ZelTroN-2k3/WelderPWM_News_Screen/photo/128x64 SSD1309, pilote IIC I2C.jpg

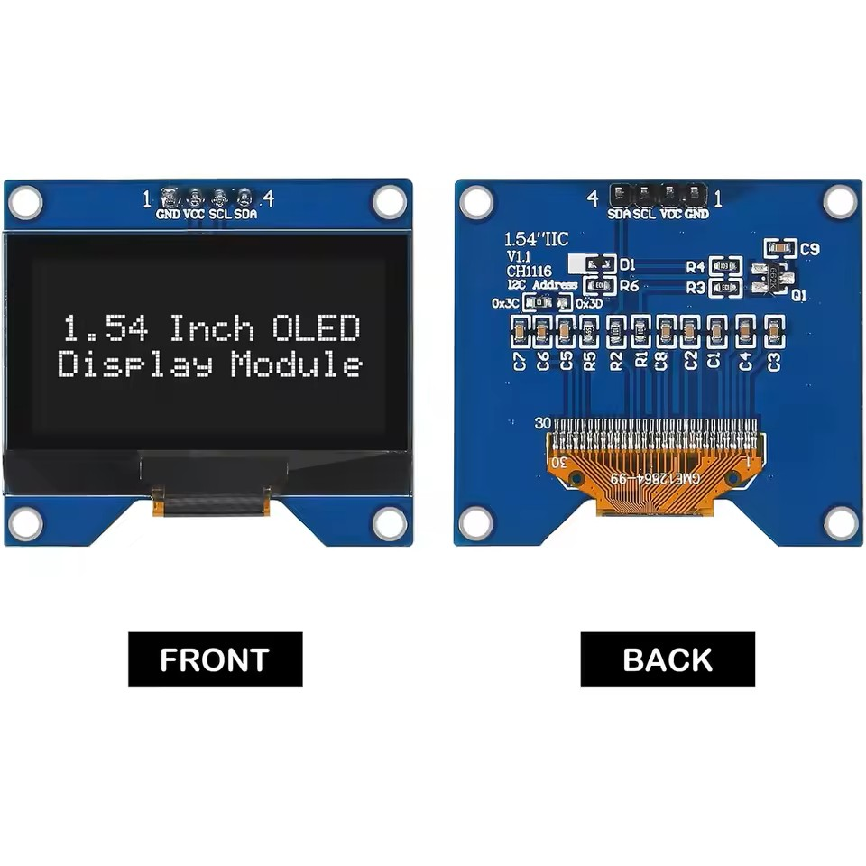
photo/128x64 SSD1309, pilote IIC I2C.jpg
