ZelTroN-2k3/WelderPWM_News_Screen/photo/5224271530660322055_120.jpg

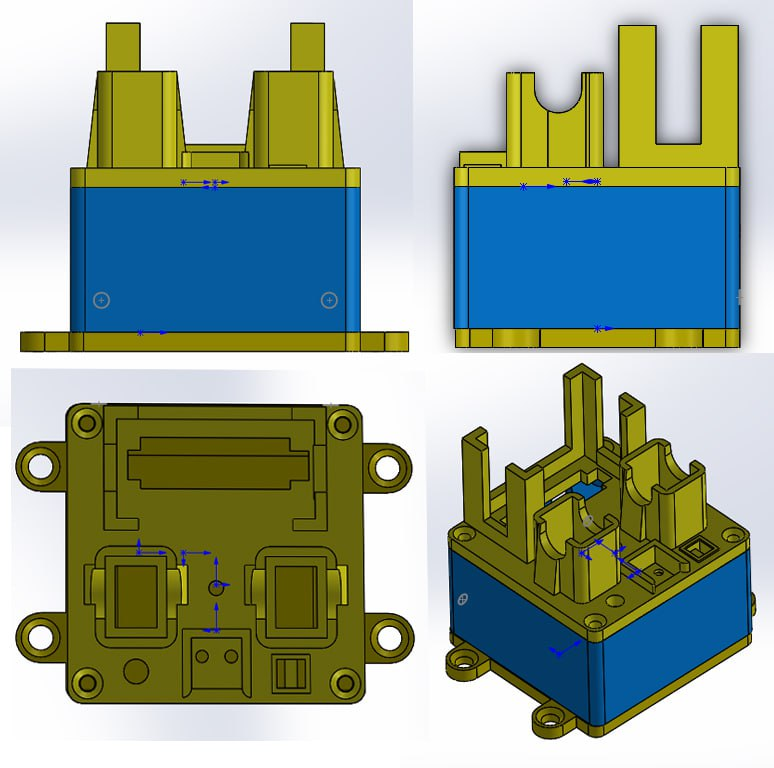
photo/5224271530660322055_120.jpg
