ZelTroN-2k3/WelderPWM_News_Screen/photo/5280480394728303123_121.jpg

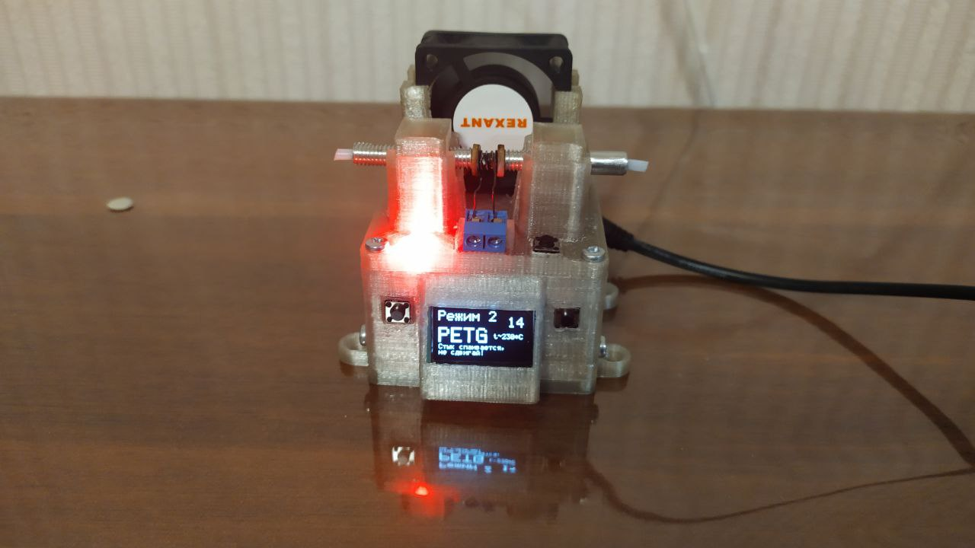
photo/5280480394728303123_121.jpg
