ZelTroN-2k3/WelderPWM_News_Screen/photo/5298588492248063706_121.jpg

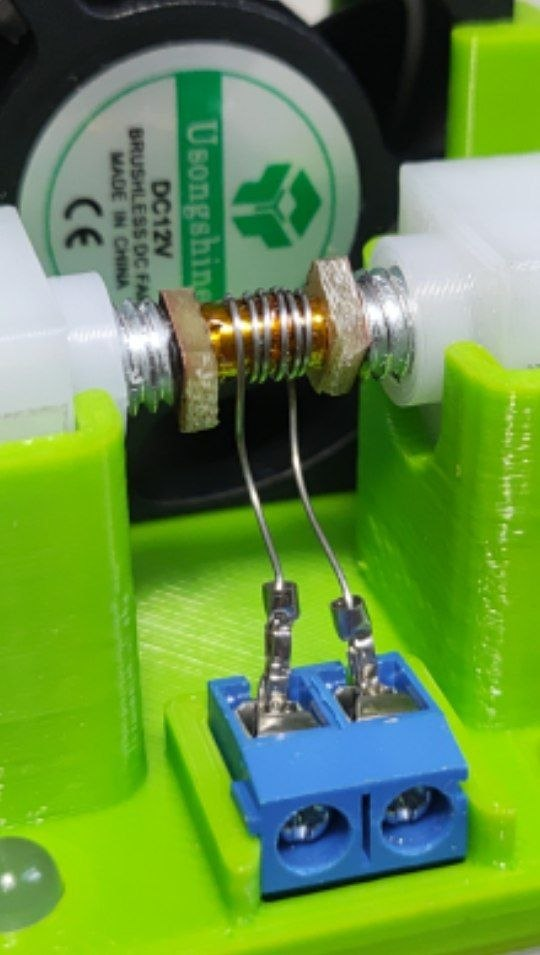
photo/5298588492248063706_121.jpg
