ZelTroN-2k3/WelderPWM_News_Screen/photo/5341638530003835500_119.jpg

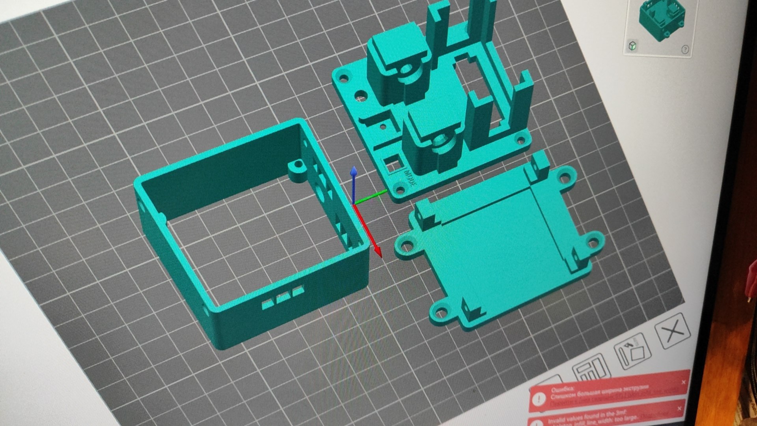
photo/5341638530003835500_119.jpg
