ZelTroN-2k3/WelderPWM_News_Screen/photo/5399879480538502821_120.jpg

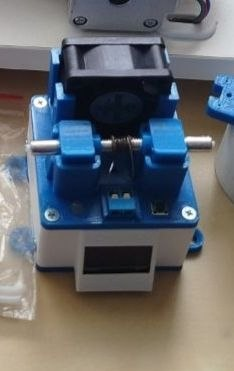
photo/5399879480538502821_120.jpg
