ZelTroN-2k3/WelderPWM_News_Screen/photo/plan-news.jpg

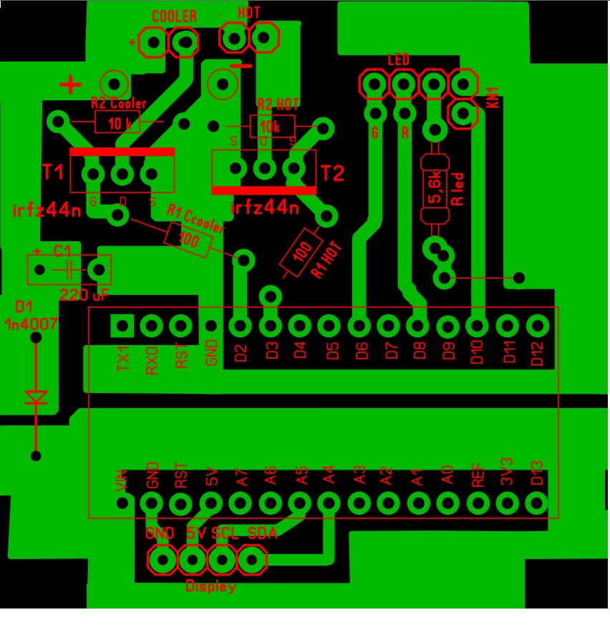
photo/plan-news.jpg
