ZelTroN-2k3/WelderPWM_News_Screen/photo/plan.png

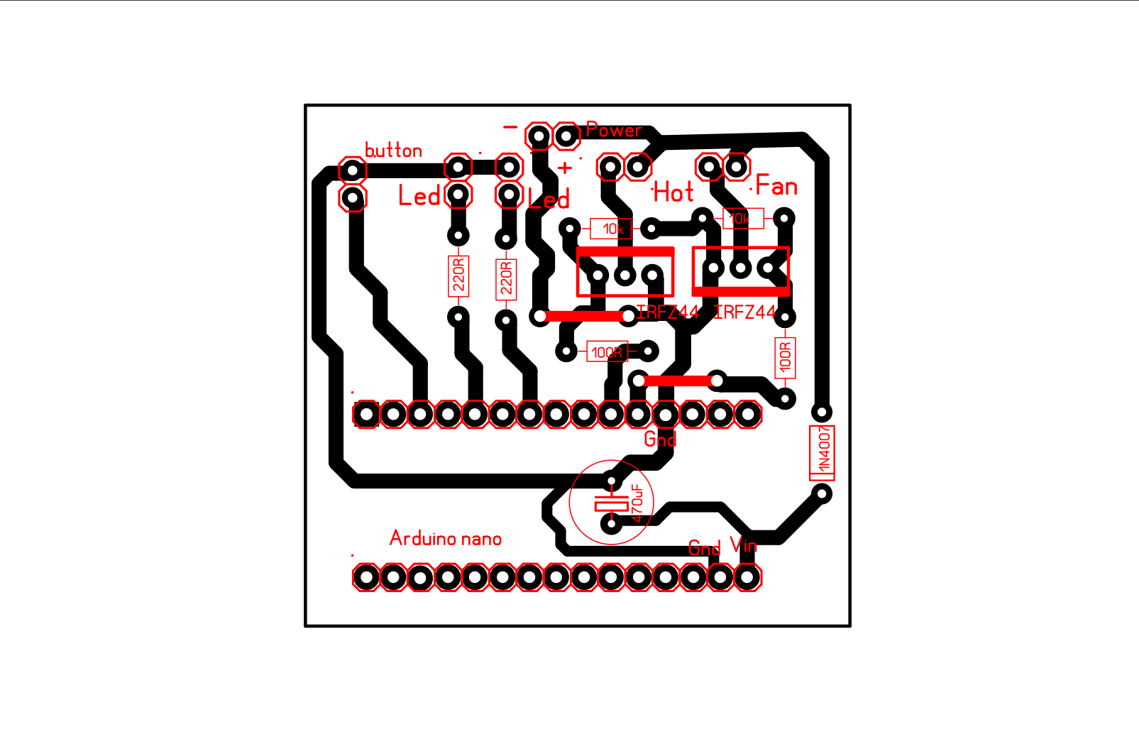
photo/plan.png
