ZelTroN-2k3/WelderPWM_News_Screen/News-Models STL/OLED-Display-Full.3mf

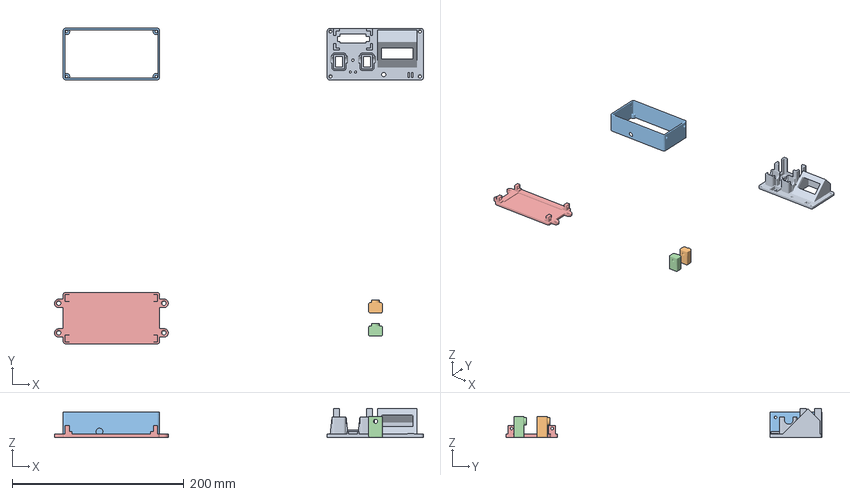
[picture p14: CAD file, 2026-08-10]
News-Models STL/OLED-Display-Full.3mf
429.2 x 367.4 x 34.0 mm
OLED-Display-Top.stl
OLED-Solder Cube.stl x 2
OLED-Display-Box.stl
OLED-Display-Side.stl
