ZelTroN-2k3/WelderPWM_News_Screen/News-Models STL/OLED-Display-Side.stl

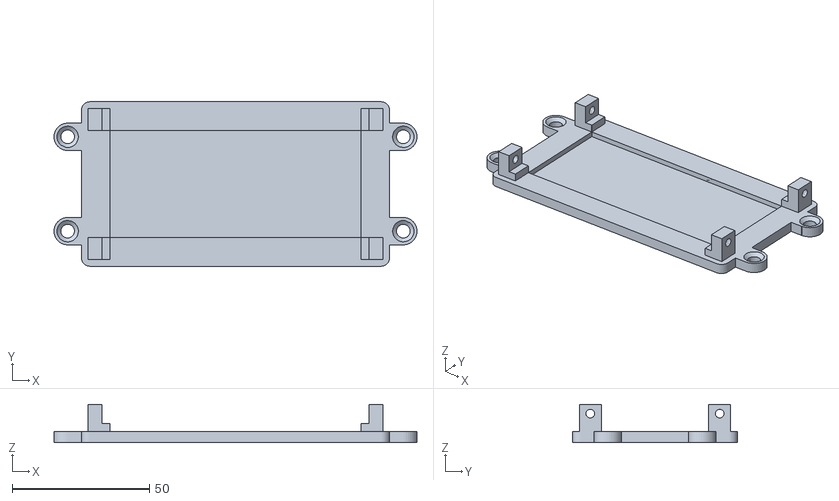
[picture p15: CAD file, 2026-08-10]
News-Models STL/OLED-Display-Side.stl
132.4 x 60.0 x 14.0
