ZelTroN-2k3/WelderPWM_News_Screen/News-Models STL/OLED-Display-Box.stl

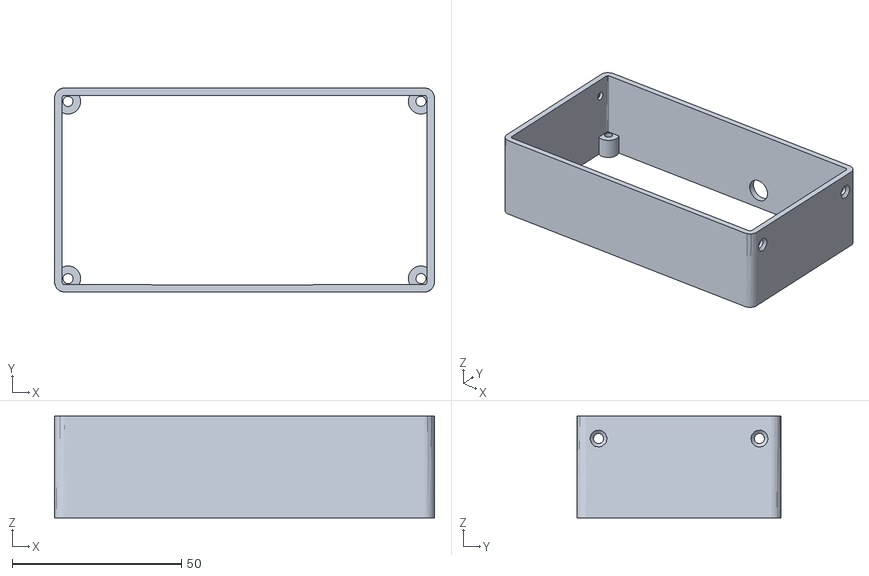
[picture p16: CAD file, 2026-08-10]
News-Models STL/OLED-Display-Box.stl
112.2 x 60.3 x 30.0
