ZelTroN-2k3/WelderPWM_News_Screen/News-Models STL/OLED-Display-Top.stl

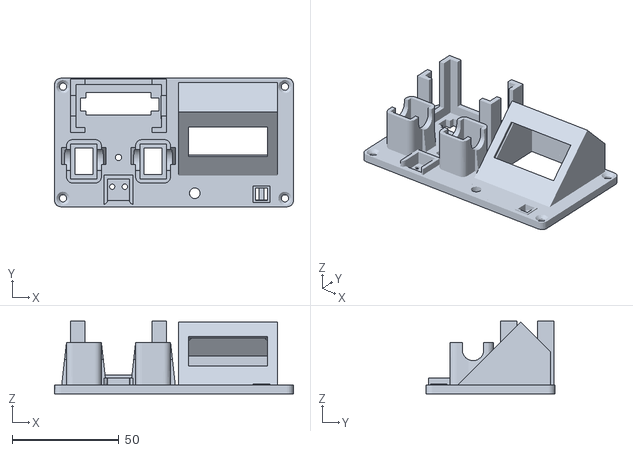
[picture p17: CAD file, 2026-08-10]
News-Models STL/OLED-Display-Top.stl
112.0 x 60.3 x 34.0
