ZelTroN-2k3/WelderPWM_News_Screen/News-Models STL/OLED-Solder Cube.stl

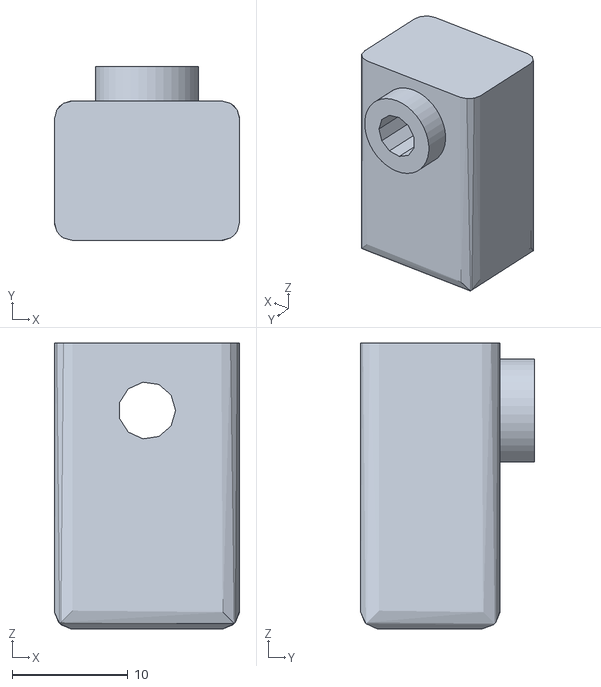
[picture p18: CAD file, 2026-08-10]
News-Models STL/OLED-Solder Cube.stl
16.0 x 15.0 x 24.8
