ZelTroN-2k3/WelderPWM_News_Screen/WelderPWM_new_3_Screen_EN/Globals.h

#ifndef GLOBALS_H
#define GLOBALS_H

#include "Config.h"
#include <U8glib.h>
#include <EncButton.h>
#include <EEPROM.h>
#include <Wire.h>

// Shared hardware objects
extern U8GLIB_SSD1306_128X64 u8g;
extern Button btn;
extern Settings settings;

// State variables
extern WorkMode workMode;
extern MenuPage currentMenuPage;
extern int menuCursor;
extern bool isEditing;

// Menu labels stored in Flash (PROGMEM)
extern const char* const mainMenuItems[MAIN_MENU_COUNT] PROGMEM;
extern const char* const settingsMenuItems[SETTINGS_MENU_COUNT] PROGMEM;

// Execution and timer variables
extern bool fanOn;
extern unsigned long workTimer;
extern unsigned long blinkTimer;
extern unsigned long iconAnimTimer;
extern unsigned long selectedHeatingPeriod;
extern int selectedMaterialIdx;
extern int currentSecLeft;

// Sleep and spark saver variables
extern unsigned long lastActivityTime;
extern bool saverActive;
extern bool sleepActive;
extern unsigned long animTimer;
extern Spark sparks[NUM_SPARKS];

#endif // GLOBALS_H
