ZelTroN-2k3/WelderPWM_News_Screen/WelderPWM_new_3_Screen_EN/MenuLogic.h

#ifndef MENULOGIC_H
#define MENULOGIC_H

#include "Globals.h"
#include "Hardware.h"
#include "Display.h"

// Button click handling and menu navigation
void handleMenuNavigation();

// Phase transition functions
void switch2Heating();
void switch2Warming();
void switch2Cooling();
void switch2ForcedCooling();
void switch2Wait();
void switch2Emergency(const char* title, const char* reason);

#endif // MENULOGIC_H
