ZelTroN-2k3/WelderPWM_News_Screen/WelderPWM_new_3_Screen_EN/ScreenSaver.cpp

#include "ScreenSaver.h"

// Spark initialization
void initSparks() {
  for (int i = 0; i < NUM_SPARKS; i++) {
    sparks[i].x = random(0, 128);
    sparks[i].y = random(0, 64);
    sparks[i].speedY = random(1, 4);
    sparks[i].speedX = random(-1, 2);
  }
}

// Spark physics update
void updateSparks() {
  for (int i = 0; i < NUM_SPARKS; i++) {
    sparks[i].y -= sparks[i].speedY;
    sparks[i].x += sparks[i].speedX;
    if (sparks[i].y < 0 || sparks[i].x < 0 || sparks[i].x > 127) {
      sparks[i].y = 63;
      sparks[i].x = random(0, 128);
      sparks[i].speedY = random(1, 4);
      sparks[i].speedX = random(-1, 2);
    }
  }
}

// Draw screensaver
void drawSparkScreenSaver() {
  u8g.firstPage();
  do {
    u8g.setFont(u8g_font_7x14B);
    int titleX = (128 - u8g.getStrWidth("WELDER PWM")) / 2;
    u8g.drawStrP(titleX, 28, PSTR("WELDER PWM"));

    u8g.setFont(u8g_font_6x10);
    int subX = (128 - u8g.getStrWidth("[ Sleep ]")) / 2;
    u8g.drawStrP(subX, 44, PSTR("[ Sleep ]"));

    for (int i = 0; i < NUM_SPARKS; i++) {
      u8g.drawPixel(sparks[i].x, sparks[i].y);
      if (i % 2 == 0) {
        u8g.drawPixel(sparks[i].x + 1, sparks[i].y);
        u8g.drawPixel(sparks[i].x, sparks[i].y + 1);
      }
    }
  } while (u8g.nextPage());
}
